defavltt/stm32-lora-spectrum-analyzer-pager/images/DSC_1575.JPG

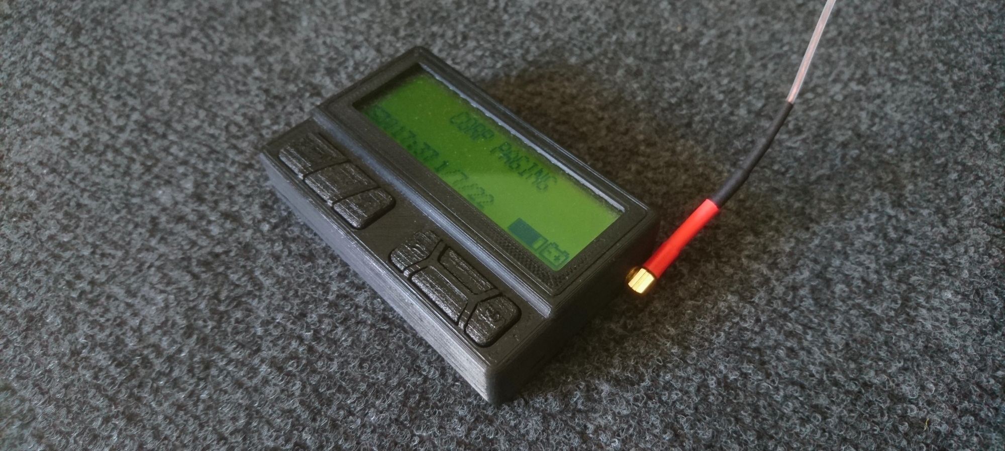
images/DSC_1575.JPG
