defavltt/stm32-lora-spectrum-analyzer-pager/source/boards/pager pcb.brd

## EAGLE design source/boards/pager pcb.brd (2025-01-29)

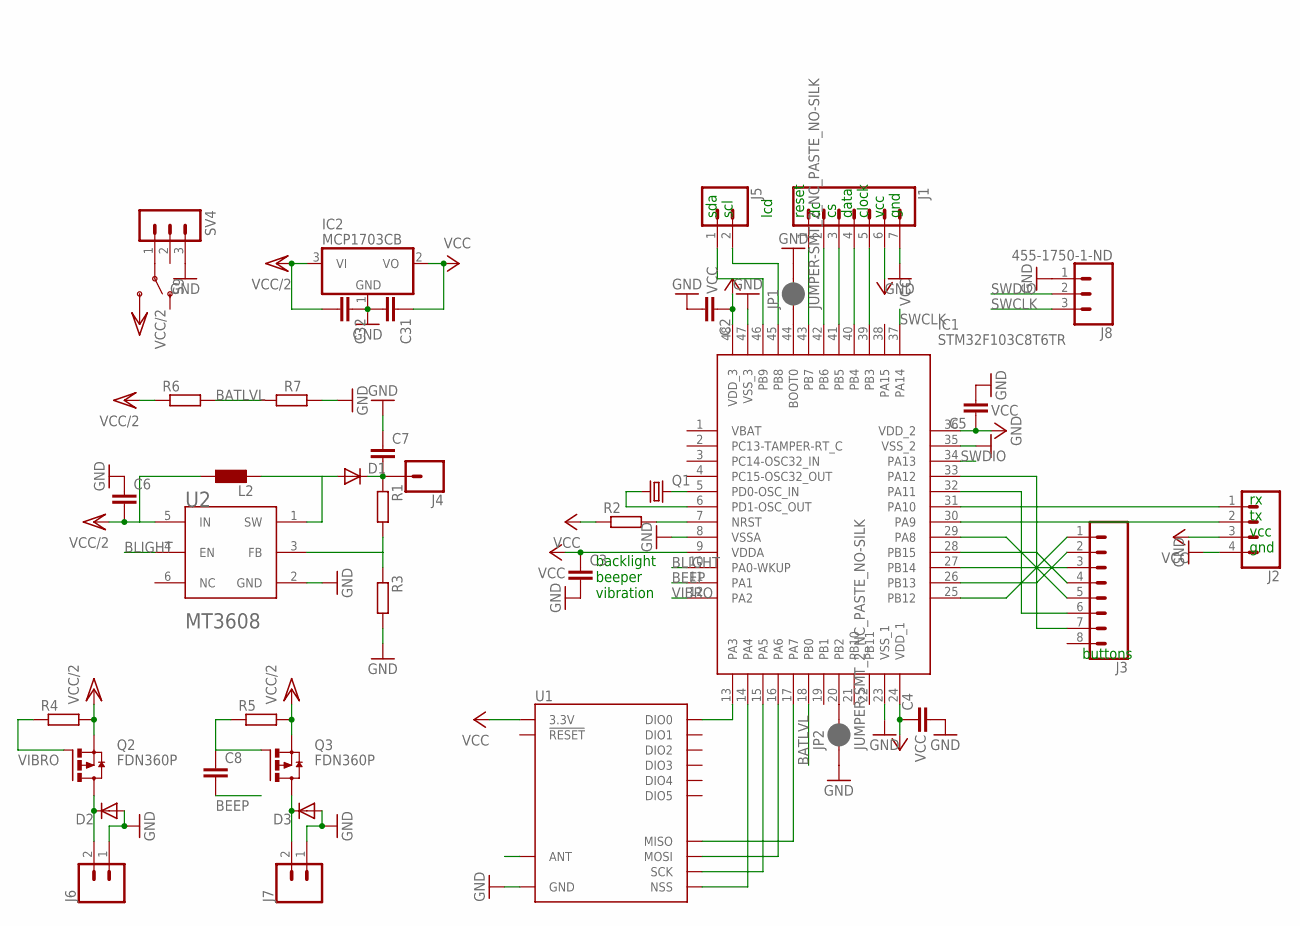
[picture p22: schematic pager pcb.sch]

Parts:
C2, C3, C4, C5, C6, C7, C8, C31, C32: C-EUC0805; C0805
D1, D2, D3: DIODE-DO-214AC; DO-214AC
IC1: STM32F103C8T6TR; QFP50P900X900X160-48N
IC2: MCP1703CB; SOT23
J1: CONN_07; 1X07
J2: CONN_04PTH; 1X04
J3: CONN_08"; 1X08
J4: CONN_01; 1X01
J5, J6, J7: CONN_02; 1X02
J8: 455-1750-1-ND; 1X03
JP1, JP2: JUMPER-SMT_2_NC_PASTE_NO-SILK; SMT-JUMPER_2_NC_PASTE_NO-SILK
L2: L0207/10; 0207/10
Q1: CRYSTALCTS406; CTS406
Q2, Q3: FDN360P; SUPER-SOT3
R1, R2, R3, R4, R5, R6, R7: R-EU_M0805; M0805
S9: SWITCH-SPDT-SMD-RIGHT-ANGLE; SWITCH_SPST_SMD_A
SV4: MA03-1
U1: RFM95W; RFM95/96/97/98W
U2: AEROSEMI_TECHNOLOGY_CO.,_LTD_MT3608AEROSEMI_TECHN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; AEROSEMI_TECHNOLOGY_CO.,_LTD_MT3608_0

Connections:
BATLVL: IC1.18 (PB0), R6.2, R7.1
BEEP: C8.2, IC1.11 (PA1)
BLIGHT: IC1.10 (PA0-WKUP), U2.4 (EN)
GND: C2.2, C3.2, C4.2, C5.2, C6.1, C7.1, C31.2, C32.1, D2.A, D3.A, IC1.8 (VSSA), IC1.23 (VSS_1), IC1.35 (VSS_2), IC1.47 (VSS_3), IC2.1 (GND), J1.7, J2.4, J6.1, J7.1, J8.1, JP1.2, JP2.1, R3.2, R7.2, SV4.3, U1.GND@1 (GND), U1.GND@2 (GND), U1.GND@3 (GND), U2.2 (GND)
unnamed: IC1.5 (PD0-OSC_IN), Q1.3 (2)
unnamed: IC1.6 (PD1-OSC_OUT), Q1.1
unnamed: IC1.7 (NRST), R2.2
unnamed: IC1.44 (BOOT0), JP1.1
unnamed: IC1.20 (PB2), JP2.2
unnamed: IC1.43 (PB7), J1.1
unnamed: IC1.42 (PB6), J1.2
unnamed: IC1.41 (PB5), J1.3
unnamed: IC1.40 (PB4), J1.4
unnamed: IC1.39 (PB3), J1.5
unnamed: IC1.31 (PA10), J2.1
unnamed: IC1.30 (PA9), J2.2
unnamed: IC1.17 (PA7), U1.MISO
unnamed: IC1.16 (PA6), U1.MOSI
unnamed: IC1.15 (PA5), U1.SCK
unnamed: IC1.14 (PA4), U1.NSS
unnamed: IC1.13 (PA3), U1.DIO0
unnamed: IC1.25 (PB12), J3.1
unnamed: IC1.26 (PB13), J3.2
unnamed: IC1.27 (PB14), J3.3
unnamed: IC1.28 (PB15), J3.4
unnamed: IC1.29 (PA8), J3.5
unnamed: IC1.33 (PA12), J3.7
unnamed: IC1.32 (PA11), J3.6
unnamed: D2.C, J6.2, Q2.3 (D)
unnamed: D3.C, J7.2, Q3.3 (D)
unnamed: IC1.46 (PB9), J5.1
unnamed: IC1.45 (PB8), J5.2
unnamed: S9.2, SV4.1
unnamed: D1.A, L2.2, U2.1 (SW)
unnamed: C7.2, D1.C, J4.1, R1.1
unnamed: C8.1, Q3.1 (G), R5.1
unnamed: R1.2, R3.1, U2.3 (FB)
SWCLK: IC1.37 (PA14), J8.3
SWDIO: IC1.34 (PA13), J8.2
VCC: C2.1, C3.1, C4.1, C5.1, C31.1, IC1.9 (VDDA), IC1.24 (VDD_1), IC1.36 (VDD_2), IC1.48 (VDD_3), IC2.2 (VO), J1.6, J2.3, R2.1, U1.3.3V
VCC/2: C6.2, C32.2, IC2.3 (VI), L2.1, Q2.2 (S), Q3.2 (S), R4.2, R5.2, R6.1, S9.3 (S), U2.5 (IN)
VIBRO: IC1.12 (PA2), Q2.1 (G), R4.1

Notes on the sheet:
buttons
backlight beeper vibration
rx tx vcc gnd
lcd reset dc cs data clock vcc gnd
sda scl

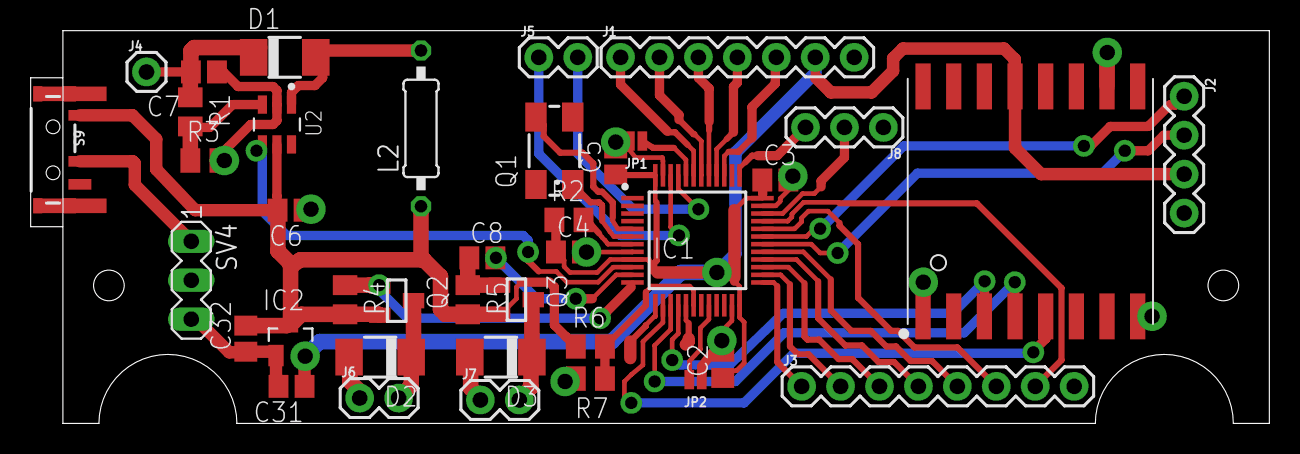
[picture p23: board pager pcb.brd from above]

Board: 2 copper layers, 80.8 x 25.6 mm, 39 parts (0 on the bottom side), 42 nets.
