defavltt/stm32-lora-spectrum-analyzer-pager/source/boards/pager button panel.brd

## EAGLE design source/boards/pager button panel.brd (2025-01-29)

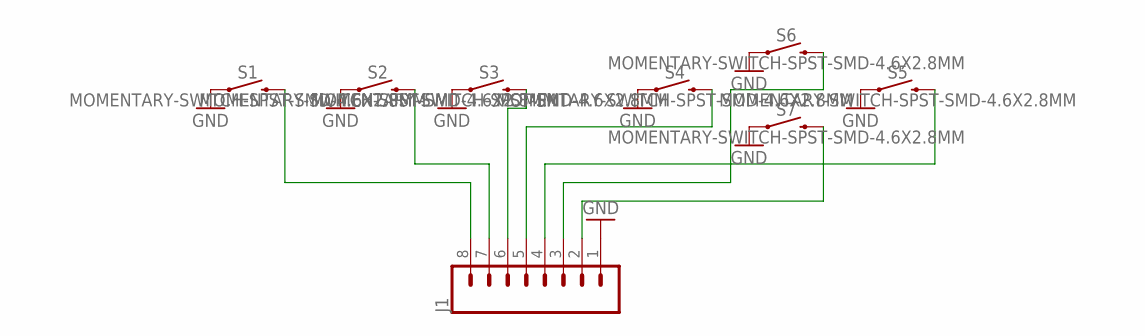
[picture p24: schematic pager button panel.sch]

Parts:
J1: CONN_08"; 1X08
S1, S2, S3, S4, S5, S6, S7: MOMENTARY-SWITCH-SPST-SMD-4.6X2.8MM; TACTILE_SWITCH_SMD_4.6X2.8MM

Connections:
GND: J1.1, S1.1, S1.2 (1), S2.1, S2.2 (1), S3.1, S3.2 (1), S4.1, S4.2 (1), S5.1, S5.2 (1), S6.1, S6.2 (1), S7.1, S7.2 (1)
unnamed: J1.8, S1.3 (2), S1.4 (2)
unnamed: J1.7, S2.3 (2), S2.4 (2)
unnamed: J1.6, S3.3 (2), S3.4 (2)
unnamed: J1.5, S4.3 (2), S4.4 (2)
unnamed: J1.4, S5.3 (2), S5.4 (2)
unnamed: J1.3, S6.3 (2), S6.4 (2)
unnamed: J1.2, S7.3 (2), S7.4 (2)

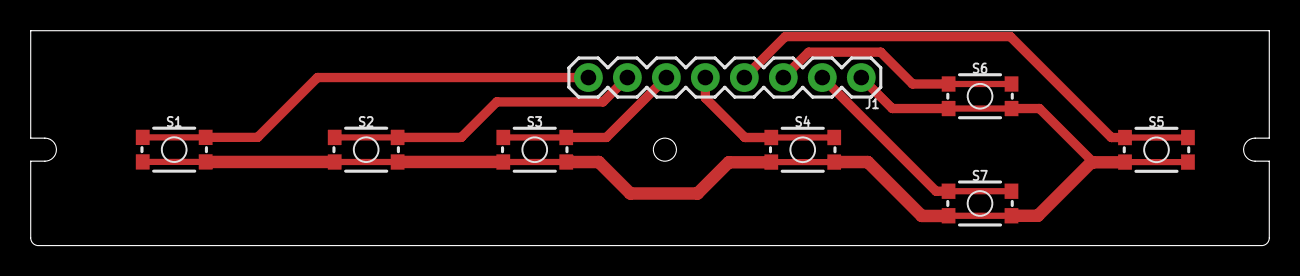
[picture p25: board pager button panel.brd from above]

Board: 2 copper layers, 80.7 x 14.0 mm, 8 parts (0 on the bottom side), 8 nets.
