defavltt/stm32-lora-spectrum-analyzer-pager/source/code/xbm.h

static const unsigned char footer[] U8X8_PROGMEM = { //132x16
  0x00, 0x00, 0x00, 0x00, 0x00, 0x00, 0x00, 0x00, 0x00, 0x00, 0x00, 0x00, 
  0x00, 0x00, 0x00, 0x00, 0x00, 0x00, 0x00, 0x00, 0x00, 0x00, 0x00, 0x00, 
  0x00, 0x00, 0x00, 0x30, 0x63, 0x00, 0x00, 0x18, 0x33, 0x00, 0x00, 0x00, 
  0x00, 0x00, 0x00, 0x00, 0x00, 0x00, 0x00, 0x00, 0x30, 0x33, 0xFE, 0xFF, 
  0x31, 0x33, 0x00, 0x00, 0xFC, 0x00, 0xF0, 0x01, 0x00, 0x70, 0x00, 0xF8, 
  0x00, 0x38, 0x33, 0xFE, 0xFF, 0x31, 0x73, 0x00, 0x00, 0xFF, 0x07, 0xFE, 
  0x0F, 0xFE, 0x7E, 0x7E, 0xFE, 0x03, 0x98, 0x31, 0x1C, 0xE3, 0x30, 0x66, 
  0x00, 0xC0, 0xFF, 0x8F, 0xFF, 0x1F, 0xFE, 0x3F, 0xFE, 0xFF, 0x03, 0x98, 
  0x19, 0x38, 0x73, 0x60, 0x66, 0x00, 0xE0, 0xFF, 0xCF, 0xFF, 0x3F, 0xFE, 
  0x7F, 0xFF, 0xFF, 0x07, 0x98, 0x19, 0x70, 0x3B, 0x60, 0x66, 0x00, 0x50, 
  0xDB, 0xE6, 0xFF, 0x2E, 0x7B, 0x35, 0x7F, 0xB7, 0x0E, 0x9A, 0x19, 0xE4, 
  0x1D, 0x68, 0x66, 0x00, 0xB7, 0xAA, 0x5D, 0x94, 0x69, 0x55, 0x5F, 0x91, 
  0x55, 0xE9, 0x52, 0xD5, 0x15, 0xE5, 0x4B, 0x55, 0x07, 0x0D, 0x7E, 0x17, 
  0xED, 0xC2, 0xC1, 0xEA, 0xC4, 0x3D, 0xBA, 0x67, 0x66, 0x6F, 0x58, 0x9D, 
  0x99, 0x0D, 0x0F, 0xFE, 0x0F, 0xFE, 0xC1, 0xC0, 0xFF, 0xC0, 0x3F, 0xF8, 
  0x67, 0xE6, 0xFF, 0xFC, 0x9F, 0x99, 0x0F, 0x0F, 0xFE, 0x0F, 0xFC, 0xC0, 
  0xC0, 0xFF, 0xC0, 0x3F, 0xF8, 0x67, 0xCE, 0xFF, 0xFC, 0xCF, 0x99, 0x0F, 
  0x0F, 0xFC, 0x0D, 0xFC, 0xE0, 0xC0, 0x7F, 0xC0, 0x1F, 0xF8, 0xC7, 0xCC, 
  0xFF, 0xFC, 0xCF, 0x8C, 0x0F, 0x0F, 0x18, 0x0C, 0x38, 0xE0, 0xE0, 0x7F, 
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
  0xFD, 0x78, 0x1C, 0x86, 0x2B, 0x88, 0x83, 0xD7, 0x03, 0x7F, 0x3C, 0x00, 
  0x32, 0xCF, 0xE7, 0x01, 0xE1, 0xFF, 0xFF, 0xFF, 0xAF, 0x0B, 0x81, 0x07, 
  0xC7, 0x83, 0x3F, 0xFD, 0xF5, 0xFF, 0xFF, 0xFF, 0x03, 0xE0, 0xFF, 0xFF, 
  0xFF, 0xFF, 0x4B, 0xA0, 0xFF, 0xC7, 0xFF, 0xFF, 0xFF, 0xFF, 0xFF, 0x7B, 
  0xFD, 0x02, 0x80, 0x5F, 0x81, 0xF6, 0xFF, 0x13, 0x80, 0xFF, 0xC3, 0xFF, 
  0xFF, 0xFF, 0xFF, 0xFF, 0x81, 0xFE, 0x05, 0xD1, 0xBA, 0x02, 0xE8, 0xFF, 
  0x05, 0xC0, 0xFF, 0xE3, 0xFF, 0xFF, 0x5F, 0x05, 0x74, 0x85, 0xFE, 0x01, 
  0x40, 0x57, 0x09, 0xD0, 0xFF, 0x17, 0x00, 0x00, 0x00, 0xF5, 0xFF, 0x5F, 
  0x00, 0xFD, 0x21, 0xFF, 0x05, 0x90, 0xAA, 0x52, 0xEA, 0xFE, 0x4A, 0x00, 
  0x00, 0x54, 0xFD, 0xFF, 0xB7, 0x00, 0x7A, 0x05, 0xFD, 0x02, 0x45, 0x41, 
  0x0A, 0xD0, 0xFF, 0x0B, 0x00, 0x00, 0x40, 0xDB, 0xFF, 0x5F, 0x80, 0xDA, 
  0x01, 0xFF, 0x05, 0x10, 0x14, 0x75, 0xD5, 0x7F, 0x2B, 0x00, 0x00, 0x52, 
  0xFD, 0xFF, 0x57, 0x09, 0xF6, 0x82, 0xFA, 0x0A, 0x4B, 0x81, 0x5A, 0xA9, 
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
